guidoglorioso01/Proyecto-DigitalesII-APOLO1/README.md

# Proyecto-DigitalesII-APOLO1
Proyecto de tecnicas digitales 2. "Apolo 1" Equipo de sonido para procesar señales de audio en tiempo real

En este repositorio existen dos proyectos:
* Proyecto_Digitales/a2dp_sink: en esta carpeta se encuentra el codigo del ESP32.
* TDII-Proyecto_Apolo-Grupo1: en esta carpeta se encuentra el codigo del nucleoF401Re

  En la carpeta "Documentacion" se encontraran todos los documentos relacionados con el proyecto y su funcionamiento.
