guidoglorioso01/Proyecto-DigitalesII-APOLO1/Documentos/Control Automático de ganancia con corrección en tiempo real V2.pdf

Control automatico de ganancia con correcci ´ | on en ´

# tiempo real

Universidad Tecnologica Nacional-FRBA ´

1

st Nicolas Tobias Alamaraz
Universidad Tecnologica Nacional-FRBA ´ CABA, Buenos Aires, Argentina nalmaraz@frba.utn.edu.ar

2

nd Guido Ignacio Glorioso Rego
Universidad Tecnologica Nacional-FRBA ´ CABA, Buenos Aires, Argentina guido.glorioso@frba.utn.edu.ar

3

rd Axel Nathanel Nahum
Universidad Tecnologica Nacional-FRBA ´ CABA, Buenos Aires, Argentina anahum@frba.utn.edu.ar

4

th Santiago Eduardo Palozzo
Universidad Tecnologica Nacional-FRBA ´ CABA, Buenos Aires, Argentina spalozzo@frba.utn.edu.ar

Abstract—Con el avance de la tecnología, los sistemas de
audio en general han dejado de ser solo exclusivos para ´ | ambitos ´
comerciales o industriales (por ejemplo cines o teatros). Podemos encontrarlos, por ejemplo, en equipos sound round, parlantes plug and play o televisores. Es por esto que el desarrollo de herramientas para controlar el audio cobra especial sentido.
En este caso se desarrollo y caracteriz ´ | o un sistema de control ´
de loudness. Es decir, un dispositivo que regule la ganancia del sistema de tal modo que independientemente de la entrada, siempre a la salida se obtiene el mismo nivel de sonoridad. Para medir loudness se utilizo la norma ITU-R BS.1770. Por ´ otro lado, para caracterizar al sistema se determino el nivel de ´
distorsion arm ´ | onica (THD) que aporta. A tal fin se probaron ´
diferentes configuraciones de loudness para la entrada. El THD fue medido tanto en la salida digital (I2S) como en la salida analogica (sobre el parlante). Se obtuvo que el caso de mayor ´
distorsion es de 1.52% en la salida anal ´ | ogica para un set point ´
de 60 LKFS y una frecuencia de 500Hz.

Index Terms—Loudness, Sistema de control, THD, AGC

I. INTRODUCCION´

A la hora de reproducir una pista de audio muchas veces ocurre que dependiendo del dispositivo que grabo el sonido, o ´ bien debido al post-procesamiento que se le aplique, existe un gran contraste entre los niveles de potencia de un stream y el otro. Por ejemplo, si reproducimos una cancion grabada en un ´ estudio y luego reproducimos un recital grabado en vivo de forma casera probablemente el nivel de sonido que perciba el oído humano sea diferente para ambas pistas de audio. Por lo
tanto, esta situacion genera una constante correcci ´ | on manual ´
por parte del usuario en el nivel de volumen del reproductor para ajustar la potencia de audio cada vez que cambie de pista. Entonces, surge la necesidad de realizar esta correccion de ´ manera automatica, buscando una mayor comodidad y mejor ´ experiencia de usuario.

La variable física que mide la potencia de audio que percibe el humano se denomina sonoridad (en ingles´ loudness) y se mide en LKFS (Loudness, K-weighted, relative to Full Scale).
Esta variable esta definida por la norma ´ | | ITU-R BS.1770 [1]
junto con su algoritmo de medicion. ´

Hoy en día es comun encontrar sistemas de control de ´ Loudness en aplicaciones mas bien industriales. Por ejem- ´ plo, en emisoras de radio, estudios de grabacion, equipos ´ de transmision de audio en vivo o en distintos software de ´
remasterizacion. Es decir est ´ | an abocados a un uso m ´ | as bien ´
profesional e industrial. Aquí priman marcas como Orban [2], SSL [3], DBX [4]. Sin embargo se pueden llegar a encontrar en algunos sistemas de audio hobbistas, por ejemplo, en procesadores de audio domesticos o distintas aplicaciones de ´ audio. Algunos ejemplos pueden ser procesadores Behringer
[5] y Yamaha [6] para sistemas home theater. En base a que no hay tanta oferta de estos sistemas en equipos plug and play de bajo costo para usuarios aficionados (no profesionales) es que se decidio desarrollar un sistema de control de loudness ´ para un procesador de audio de propia autoría.
A. ¿Que es el loudness?
Segun la ´ | norma antes mencionada, el nivel de loudness de
una senal se refiere a la percepci ˜ | on subjetiva de la intensidad ´
o volumen de un sonido por parte de un oyente. En otras palabras, es la medida de cuan fuerte o suave se escucha una ´
senal de audio en funci ˜ | on de c ´ | omo la percibe el o ´ | ído humano.
El loudness no se mide directamente en decibelios (dB), como lo haría el nivel de presion sonora, sino que tiene en cuenta la ´ sensibilidad del oído humano a diferentes frecuencias y ajusta la medicion en consecuencia. ´

B. ¿Como se mide el loudness? ´

Como ya mencionamos al comienzo de esta seccion, la ´ norma ITU-R BS.1770 propone un algoritmo para la medicion´ de loudness de un stream de audio (medido en LKFS).
De esta manera, el objetivo es cuantificar el nivel de
loudness de una senal de manera representativa para el o ˜ | ído
humano y en base a ello ajustar el nivel de sonoridad. Este ajuste no debe ser destructivo para la senal, buscando tener ˜ la menor distorsion posible. Sin embargo, hay que tener en ´ cuenta que dicha correccion implica una ganancia variable en ´ el tiempo, dando lugar a posibles distorsiones en la senal. ˜

II. METODOLOGÍA GENERAL

El sistema de control tiene un diagrama en bloques como el siguiente (fig. 1):

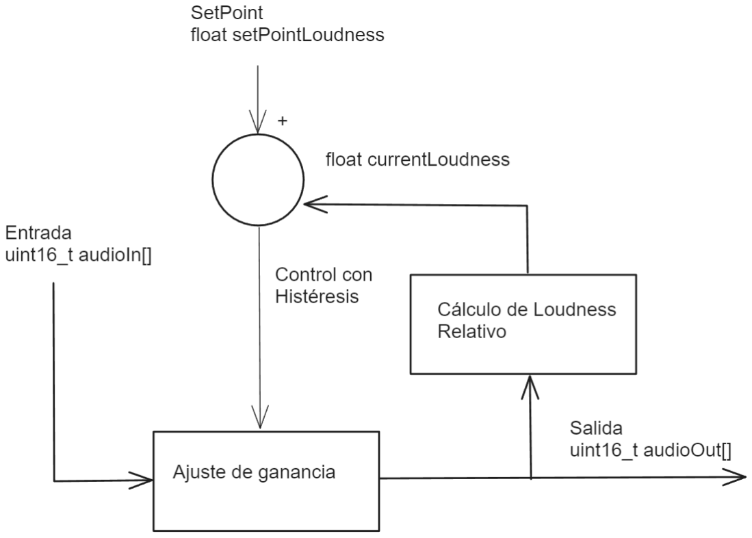
[picture p3: figure]

Fig. 1. Diagrama en bloques

Las etapas son:

- Entrada: senal de audio de entrada ˜
- Ajuste de ganancia: correccion en base al loudness con ´ un nivel de histeresis ´
- Set Point: valor de referencia de Loudness configurado por el usuario
- Calculo de loudness relativo: Este es el algoritmo que plantea la norma para la medicion de Loudness ´
- Salida de audio: senal de audio con la correcci ˜ | on´
pertinente

En este sistema se recibe un stream de audio vía Bluetooth
[7] y se le aplica el algoritmo de medicion de loudness. Luego, ´ en funcion del valor obtenido se le aplica una ganancia que ´
amplifique o atenue la se ´ | nal para que el nivel de loudness se ˜
mantenga en el valor configurado por el usuario.
A. Algoritmo de medicion de Loudness ´

Para medir el nivel de sonoridad la norma ITU indica los siguientes pasos:

Primero, aplicarle los filtros que adapten la senal pon- ˜
derando en funcion del comportamiento del o ´ | ído humano
(filtros digitales con coeficientes definidos por la norma a 48kHz). Este filtro es aplicado a cada canal.
Segundo, se calcula la potencia de la senal dividida en blo- ˜ ques de tiempo con un solapamiento determinado (recomienda bloque de 0.4 segundos y 75% de solapamiento). En otras
palabras se toman los ultimos 0.4 segundos de informaci ´ | on y ´
se calcula la potencia. Luego, se avanzan 0.1 segundos y se vuelve a calcular la potencia de los siguientes 0.4 segundos. Se repetira el proceso con la totalidad del stream de audio. ´ Tercero, se le aplica la siguiente expresion a cada bloque ´ de potencia calculado.

LKG = −0.691 + 10 log10X

i

Gi

1
|Jg|

X

Jg

Zij

- − 10LKF S

(1)

Donde:

- i: Representa los distintos canales. Por ejemplo canal izquierdo, derecho, sub-woofer, etc
- Gi
: coeficientes de ponderacion de cada canal ´
- Zij : Energía de la senal en un tiempo de gate para el ˜ canal i en el bloque de tiempo j
- Jg: Son los elementos que superan el umbral de disparo de 70 LKFS
- |Jg|: Cantidad de elementos que superan el umbral de disparo
B. Adaptacion del algoritmo para utilizarse dentro de un ´ microcontrolador en tiempo real

Para adaptar el algoritmo al microcontrolador es necesario resolver dos problematicas principalmente. La primera es que ´ no es un algoritmo nativo para aplicarse en tiempo real y la segunda es que el hecho de tener que almacenar grandes tiem-pos de audio es sumamente inviable para un microcontrolador que esta muy limitado en memoria. ´

Para resolver la primera problematica se adopt ´ | o por imple- ´
mentar un buffer circular que almacene los ultimos 3 segundos ´ de audio. Estos son los que representan el período total del calculo. Es decir, se aplicaron las ventanas de 0.4 segundos ´ sobre este buffer de 3 segundos.

Por otro lado, al tener que resolver una integral de períodos de 0.4 segundos de manera reiterativa se opto por definir ´ sub-ventanas de 0.1 segundos. De esta manera se redujo el costo computacional, dado que el unico procesamiento que ´ debería hacer el sistema es calcular la energía de los ultimos ´ 0.1 segundos y aprovechar todo el procesamiento previo para así ir formando los bloques de 0.4 segundos. Puede verse graficamente este proceso con la siguiente imagen (fig. 2) ´

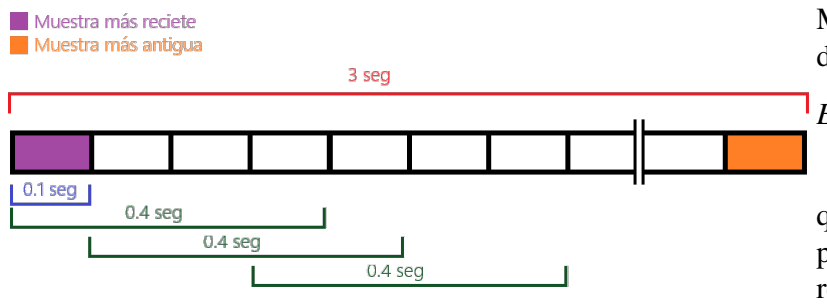
[picture p4: figure]

Fig. 2. Enter Caption

C. Ajuste de ganancia

Luego de analizar el desempeno de distintos algoritmos de ˜
correccion, se opt ´ | o por un agregar un nivel de hist ´ | eresis H ´
al sistema de forma que una vez conseguido un equilibrio no
varíe la ganancia por aumentos pequenos de se ˜ | nal. El valor ˜
de H quedo definido en 5 LFKS de manera emp ´ | | írica ya que
conseguía los mejores resultados.
D. Diagranma en bloques del Hardware

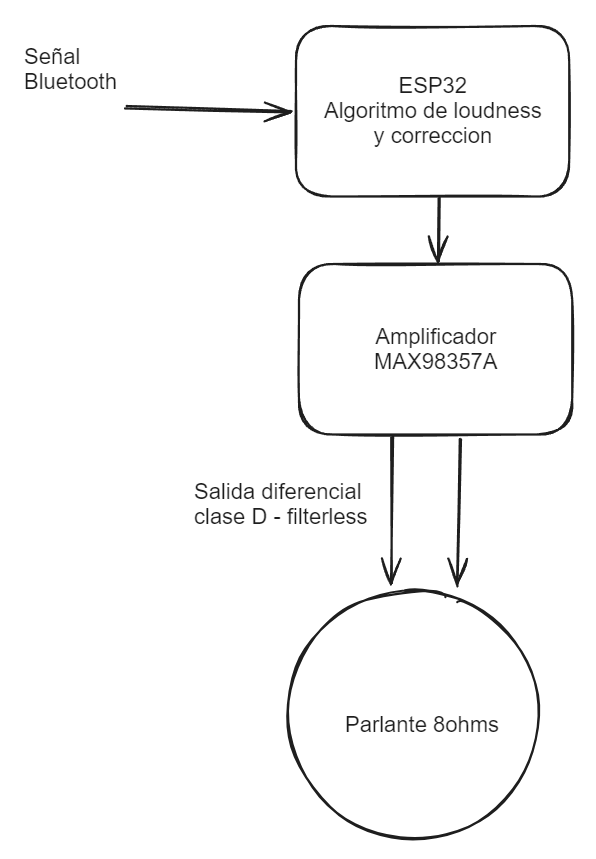
[picture p5: figure]

Fig. 3. Hardware

(fig. 3)
En cuanto a Hardware se tiene un microcontrolador ESP32
[8] utilizado para desarrollar el sistema de control. Mediante
este, se gestiona la recepcion de la se ´ | nal de audio v ˜ | ía Bluetooth
y aplica el proceso de medicion de loudness para as ´ | | í definir
un valor de ganancia.

En cuanto a la salida, el microcontrolador entrega una
senal I2S [9] que es recibida por un m ˜ | odulo amplificador ´

MAX98357A [10]. Estese encarga de recibir la senal I2S, ˜ decodificarla y amplificarla con un amplificador clase D.

E. Interfaz de usuario
Para controlar el SetPoint se disenõ una aplicaci ´ | on de PC ´
que se conecta con el microcontrolador vía UART [11] y permite ademas graficar los valores de loudness en tiempo ´
real, ademas de ir guard ´ | andolos en un archivo ´ | CSV (Comma-
Seperated Values).

Seleccion de puerto y loudness: ´

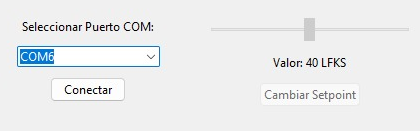
[picture p6: figure]

Fig. 4. Seleccion de puerto y loudness del sistema ´

En primer lugar se observa la seleccion del ´ | puerto y el
loudness (fig. 4). Esta misma funciona de la siguiente manera:
Seleccion de puerto: ´ | Se debe seleccionar el puerto, una
vez conectado el sistema a la PC. Al pulsar el boton conectar, ´ ya se podra actuar sobre el sistema. ´

Cambiar SetPoint: Se elije el valor de loudness que se requiera para el sistema. Este se enviara al microcontrolador ´
mediante la comunicacion serie ´ | UART.

Iniciar/parar ploteo: comienza o termina el registro de datos ploteando los ultimos 30 segundos y guardando el ´ registro completo en un archivo CSV (fig. 5).

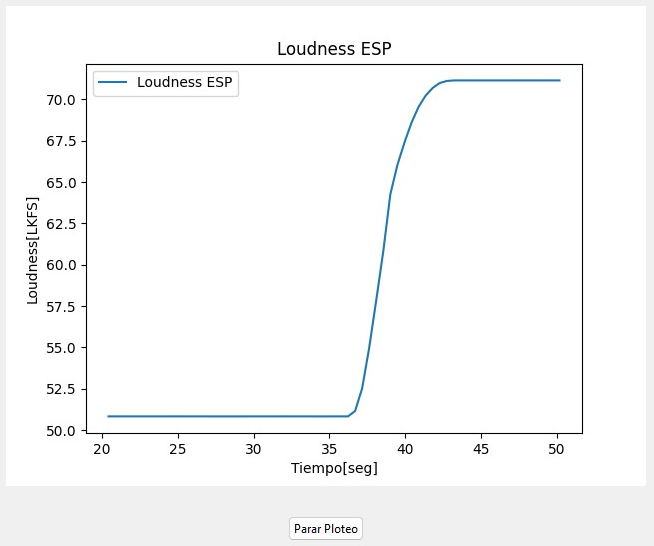
[picture p7: figure]

Fig. 5. Grafico de Loudness en funcion del tiempo

III. PROCESAMIENTO DE LOS DATOS

A. Magnitud a medir

Dado que hay una ganancia variable en funcion del tiempo, ´ es de interes conocer el THD (Total harmonic distortion) [12] ´
del sistema. Por lo tanto, se realizo la medici ´ | on de THD para ´
diferentes valores de loudness teniendo como senal de entrada ˜ un tono senoidal puro a distintas frecuencias.
B. Esquema de medicion´

El primer punto de medicion del sistema se encuentra a la ´ salida del microcontrolador. Esta senal es del tipo I2S, por lo ˜ tanto se mide con un analizador logico. El segundo punto de ´ medicion es a la salida del amplificador. El mismo cuenta con ´ una salida tipo bridge o diferencial, con lo cual es necesario medir la senal de ambos bornes de entrada del parlante. Para ˜
las mediciones realizadas se adopto el esquema de conexi ´ | on´
de la figura 6.
C. Tonos de prueba

Para caracterizar el sistema, se utilizo una senal de entrada ˜ senoidal a distintas frecuencias (500, 1000 y 10.000 Hz) y distintos valores de loudness (50, 60 y 70 LFKS). Se eligieron estos valores debido a que cubren gran parte del espectro audible [13] (que para un oído joven y sano va de 20Hz a 20kHz) y por otro lado, con los valores de referencias adoptados se cubren los niveles de Loudness mas frecuentes ´ para un usuario promedio.

D. Adaptacion de salida del modulo amplificador ´

Un aspecto a tener en cuenta sobre las mediciones es que los amplificadores MAX98357 son del tipo clase D y debido a su principio de funcionamiento en la salida se presenta una portadora de 300KHz combinada con la senal de audio. Esto ˜ implica que para recuperar la informacion hay que filtrar la ´ portadora. Una vez llegado a este punto que se tiene el stream de audio limpio se le aplica el algoritmo de THD para evaluar la distorsion. ´

Para visualizar el comportamiento del amplificador clase D, se calculo la ´ FFT [14] (Fast Fourier Transform) a la senal de ˜ salida del sistema antes y despues del filtrado para observar ´ las componentes frecuenciales que esta presenta.

E. Instrumentos y hardware utilizado

Para las mediciones se utilizaron los siguientes equipos de medicion: ´

- Analizador logico Duaitek LA2408 [15] ´
- Osciloscopio Agilent MSO-X 3024A [16]

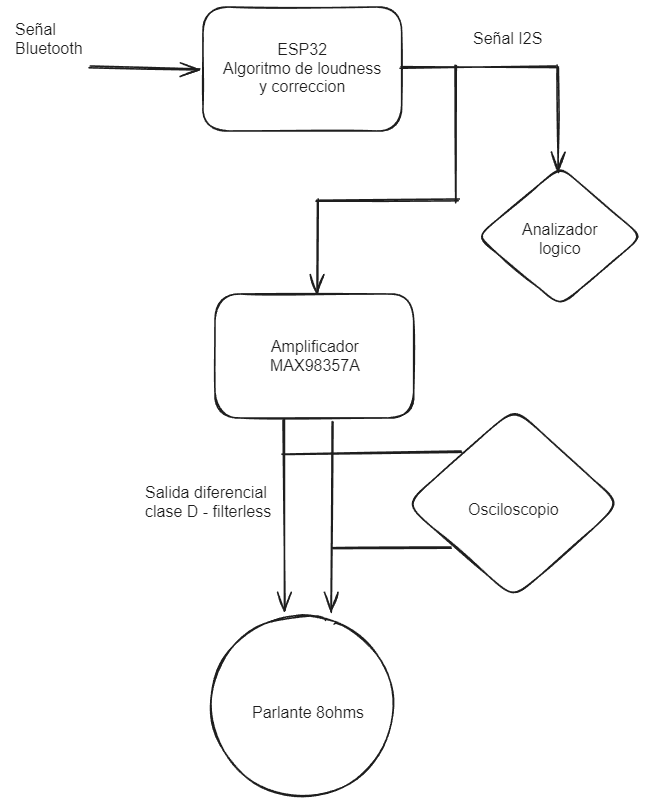
[picture p8: figure]

Fig. 6. Esquema de conexion del banco de medici ´ | on´

IV. RESULTADOS

Se adjuntan los diferentes graficos intermedios antes de ´
obtener el THD de las senales para la se ˜ | nal de prueba ˜
de 500Hz con un setpoint de 60LKFS tanto para la senal ˜ analogica como para la digital. Cabe destacar que este proceso ´ debe repetirse para cada una de las mediciones, es decir, todas las frecuencias con todos los set points. Para visualizar
todos los graficos de cada medici ´ | on puede consultarse en ´ | [2]
(Apendice) ´ | .
A. Senal anal ˜ | ogica a 500Hz con 60 LKFS ´

En la fig. 7 se observa la senal de ambos canales referidas a ˜ tierra. Este oscilograma es para mostrar que ambas senales por ˜
separado no permiten la reconstruccion de la se ´ | nal original. ˜

En la fig. 8 se muestra la diferencia entre la senal de ambos ˜ canales del osciloscopio. Puede verse que se tiene la portadora de una muy alta frecuencia y la senal que modula a dicha ˜ portadora.

Por otro lado, en la fig. 9 puede verse la FFT de la senal ˜ diferencial anterior. Se observa que en las bajas frecuencias
esta la senoidal de inter ´ | es y en 150kHz est ´ | a la se ´ | nal portadora. ˜
Haciendo pruebas puede verse que esta portadora es una senal ˜
cuadrada y dependiendo de cual es la se ´ | nal de informaci ˜ | on´

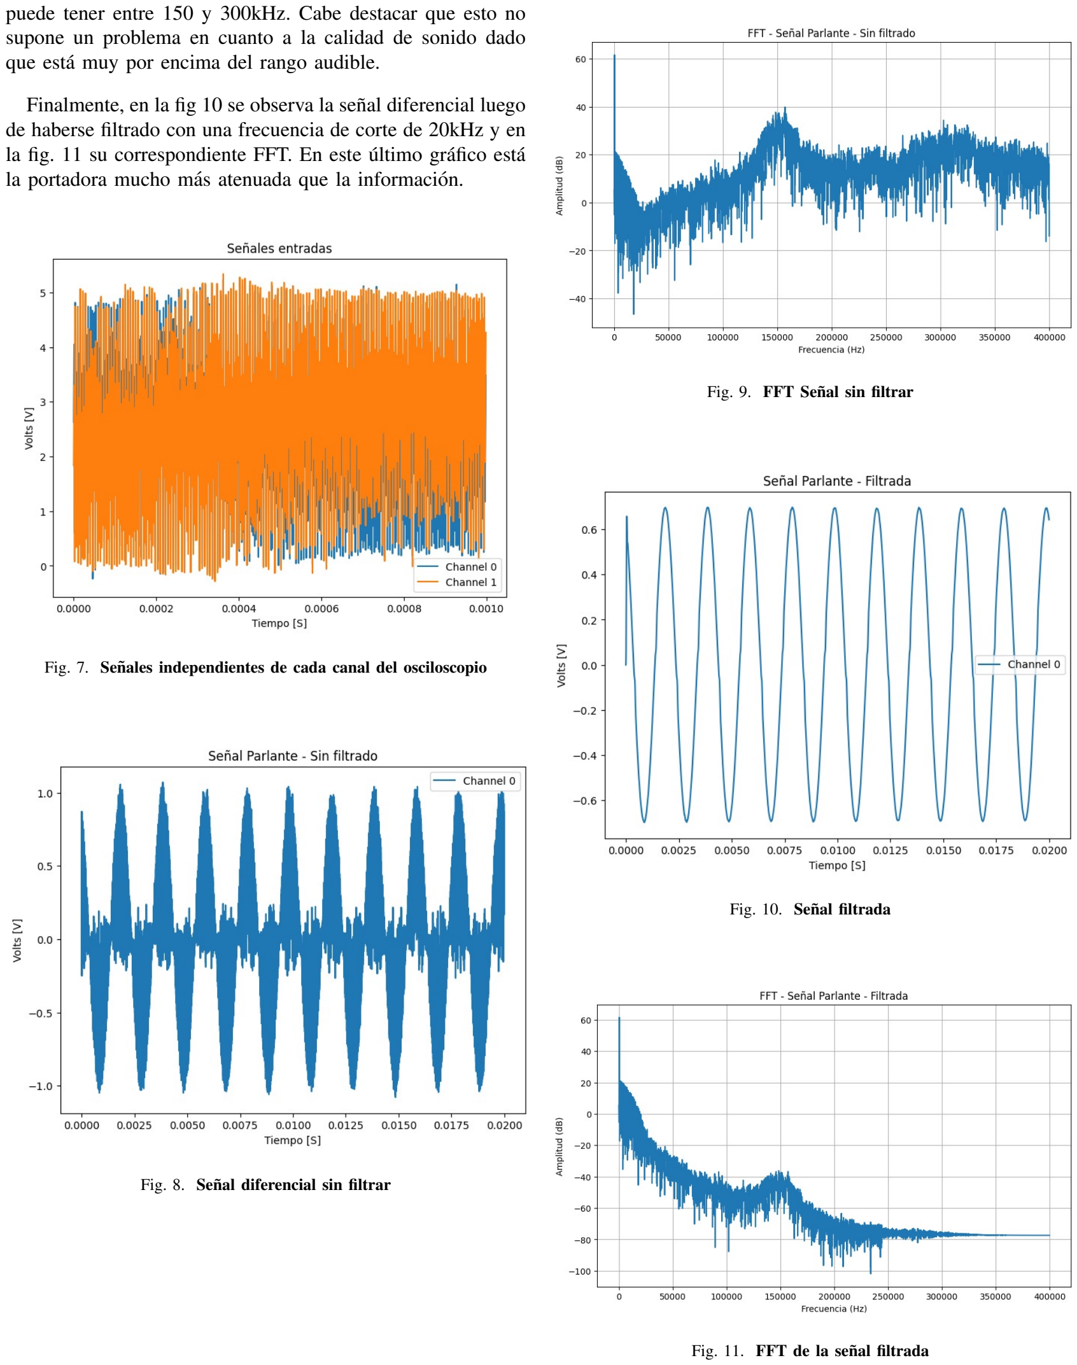
[picture p9: page 5]

puede tener entre 150 y 300kHz. Cabe destacar que esto no supone un problema en cuanto a la calidad de sonido dado que esta muy por encima del rango audible. ´

Finalmente, en la fig 10 se observa la senal diferencial luego ˜ de haberse filtrado con una frecuencia de corte de 20kHz y en
la fig. 11 su correspondiente FFT. En este ultimo gr ´ | afico est ´ | á
la portadora mucho mas atenuada que la informaci ´ | on. ´

Fig. 7. Senales independientes de cada canal del osciloscopio ˜

Fig. 8. Senal diferencial sin filtrar ˜

Fig. 9. FFT Senal sin filtrar ˜

Fig. 10. Senal filtrada ˜

Fig. 11. FFT de la senal filtrada ˜

B. Senal digital a 500Hz 60 LKFS ˜

En la fig. 12 se observa la senal temporal medida con el ˜ analizador logico a la salida del microcontrolador y en la fig. ´ 13 se observa su correspondiente FFT.

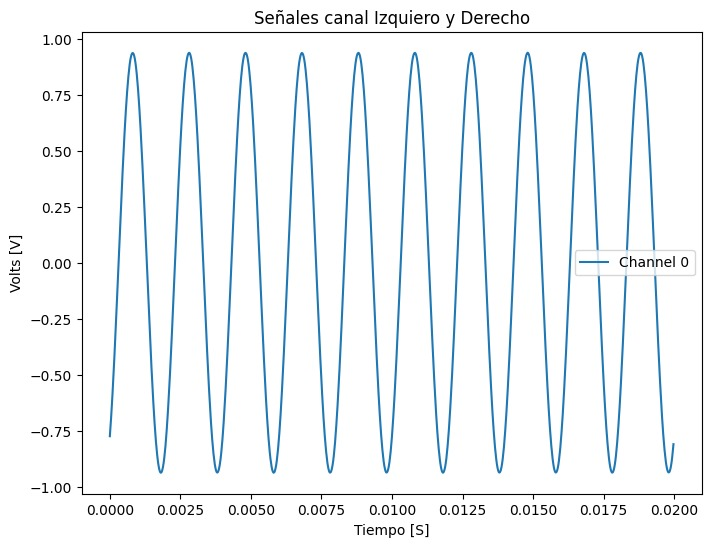
[picture p10: figure]

Fig. 12. Senal I2S ˜

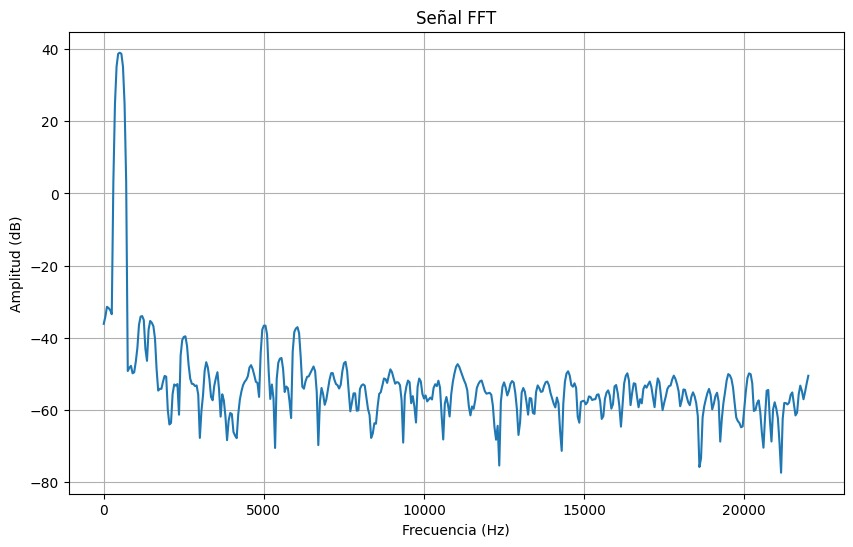
[picture p11: figure]

Fig. 13. FFT de la senal I2S ˜

C. Tabla con los resultados obtenidos de THD

Analizando cada una de las senales senoidales con cada ˜ uno de los set-points se obtubieron los resultados de la tabla
1 (resultados senal I2S) y tabla 2 (resultados se ˜ | nal anal ˜ | ogica). ´
Parametro ´ | 70 LKFS | 60 LKFS | 50 LKFS
THD % - ESP32 (500Hz) | 0,548% | 0,235% | 0,527%
THD % - ESP32 (1KHz) | 0,453% | 0,354% | 0,202%
THD % - ESP32 (10KHz) | 0,059% | 0,124% | 0,229%

TABLE I

Parametro ´ | 70 LKFS | 60 LKFS | 50 LKFS
THD % - Parlante (500Hz) | 1,25% | 1,52% | 1,03%
THD % - Parlante (1KHz) | 0,56% | 0,97% | 0,9%
THD % - Parlante (10KHz) | 0,33% | 0,33% | 0,33%

TABLE II

V. ANALISIS DE LOS RESULTADOS Y CONCLUSIONES ´

En base a las tablas de resultados (tabla 1 y tabla 2), se
observa que la tasa de distorsion aumenta para se ´ | nales de ˜
menor frecuencia y ademas aumenta cuando estamos en un ´ rango de LKFS cercano a 60.

Por otro lado, puede verse que el mayor aporte de distorsion´ lo hace el modulo amplificador. Esto podemos verlo en la ´
comparacion de los THD de la se ´ | nal digital y la anal ˜ | ogica ´
respectivamente.
Por ultimo, el peor caso de distorsi ´ | on se dio con una se ´ | nal ˜
de entrada de 500Hz con un nivel de loudness de 60 LKFS obteniendo un THD de 1.52%.
| VI. DESARROLLO A FUTURO

Una de las mejoras a futuro resulta ser la medicion del ´ THD en el transitorio, es decir, mientras que la senal se ˜ este estabilizando entre dos puntos de trabajo (porque cambio el setpoint). Esto se debe realizar mediante la salida digital debido a que el transitorio dura aproximadamente unos 10 segundos. Esto supone un problema para medirse con el osciloscopio debido la profundidad de memoria (no se podrá realizar mediante la salida analogica). ´

Por otro lado, se podría realizar un grafico de THD en ´ funcion del setpoint de loudness elegido y parametrizando ´ diferentes frecuencias. Para conseguir esto de una manera mas precisa se deben realizar las mediciones para una mayor cantidad de setpoints y frecuencias de trabajo.

APENDICE ´

[1] NBviewer de Loudness (https://nbviewer.org/github/guidoglorioso01/Jupyter-Notes/blob/main/Controlador%20de%20Loudness/Control%20de%20loudness.ipynb)
[2] NBviewer de resultados (https://nbviewer.org/github/guidoglorioso01/Proyecto-Medida_1-G1/blob/main/Notebooks/Mediciones%20y%20resultados/notebook%20Proyecto.ipynb)
[3] NBviewer de datos (https://nbviewer.org/github/guidoglorioso01/Proyecto-Medida_1-G1/tree/main/Notebooks/)

REFERENCES

[1] Norma ITU-R BS.1770 (https://extranet.itu.int/brdocsearch/R-REC/R-REC-BS/R-REC-BS.1770/R-REC-BS.1770-4-201510-I/R-REC-BS.1770-4-201510-I!!PDF-S.pdf)
[2] Orban (https://www.orban.com/)
[3] SSL (https://www.solidstatelogic.com/)
[4] DBX (https://dbxpro.com/en)
[5] Procesadores Behringer (https://www.behringer.com/behringer/search-results.html?brandName=behringer&queryStr=processor)

[6] Procesadores Yamaha (https://es.yamaha.com/es/search/index.html?search=procesadores)
[7] Bluetooth-A2DP-API-Application-Example (https://docs.espressif.com/projects/esp-idf/en/latest/esp32/api-reference/bluetooth/esp_a2dp.html)
[8] ESP32 (https://www.espressif.com/en/products/socs/esp32)
[9] Inter-IC Sound (I2S) (https://docs.espressif.com/projects/esp-idf/en/stable/esp32/api-reference/peripherals/i2s.html)
[10] Datasheet del amplificador MAX98357 (https://www.analog.com/media/en/technical-documentation/data-sheets/max98357a-max98357b.pdf)
[11] Universal Asynchronous Receiver/Transmitter (UART) (https://docs.espressif.com/projects/esp-idf/en/latest/esp32/api-reference/peripherals/uart.html)
[12] Distorsion arm ´ onica total (THD) ´ (https://es.wikipedia.org/wiki/Distorsi%C3%B3n_arm%C3%B3nica)
[13] Espectro audible (https://es.wikipedia.org/wiki/Espectro_audible)
[14] FFT (https://es.wikipedia.org/wiki/Transformada_r%C3%A1pida_de_Fourier)
[15] Analizador logico Duaitek LA2408 ´ (https://www.uctronics.com/download/Amazon/U6041_Saleae.pdf)
[16] Osciloscopio Agilent MSO-X 3024A (https://www.testequipmenthq.com/datasheets/Agilent-MSOX3024A-Datasheet.pdf)
