guidoglorioso01/Proyecto-DigitalesII-APOLO1/Proyecto_Digitales/a2dp_sink/components/esp-dsp-master/docs/esp_bm_results.csv

# This contents of this file is produced by running "DSP Benchmarks data" tests as explained in ESP-IDF Programming Guide and
# README.me for ESP-DSP.
# When updating this file | remember to run build_bm_table.py script to rebuild the table in documentation.
Esp32s3
**Dot Product**
dsps_dotprod_f32 for N=256 points | 449 | 1330 | 1 | 3
dsps_dotprode_f32 for N=256 points with step 1 | 1326 | 2603 | 1 | 3
dsps_dotprod_s16 for N=256 points | 323 | 3397 | 1 | 3
**FIR Filters**
dsps_fir_f32 1024 input samples and 256 coefficients | 443690 | 1350673 | 1 | 3
dsps_fird_f32 1024 samples 256 coeffs and decimation 4 | 115494 | 349202 | 1 | 3
**FFTs Radix-2 32 bit Floating Point**
dsps_fft2r_fc32 for 64 complex points | 5142 | 6850 | 1 | 3
dsps_fft2r_fc32 for 128 complex points | 11706 | 15638 | 1 | 3
dsps_fft2r_fc32 for 256 complex points | 26303 | 34939 | 1 | 3
dsps_fft2r_fc32 for 512 complex points | 58435 | 77175 | 1 | 3
dsps_fft2r_fc32 for 1024 complex points | 128697 | 169738 | 1 | 3
**FFTs Radix-4 32 bit Floating Point**
dsps_fft4r_fc32 for 64 complex points | 3345 | 5119 | 1 | 3
dsps_fft4r_fc32 for 256 complex points | 15522 | 25223 | 1 | 3
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
