guidoglorioso01/Proyecto-DigitalesII-APOLO1/TDII-Proyecto_Apolo-Grupo1/Core/Src/main.c

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
/* Includes ------------------------------------------------------------------*/
#include "main.h"
#include "cmsis_os.h"
#include "app_touchgfx.h"

/* USER CODE BEGIN PTD */
#include "Driver_I2S.h"
#include "process.h"
/* USER CODE END PTD */

ADC_HandleTypeDef hadc1;

CRC_HandleTypeDef hcrc;

I2C_HandleTypeDef hi2c1;

I2S_HandleTypeDef hi2s2;
I2S_HandleTypeDef hi2s3;
DMA_HandleTypeDef hdma_spi2_rx;
DMA_HandleTypeDef hdma_spi3_tx;

SPI_HandleTypeDef hspi1;
DMA_HandleTypeDef hdma_spi1_tx;

TIM_HandleTypeDef htim1;
TIM_HandleTypeDef htim2;

UART_HandleTypeDef huart2;

osThreadId defaultTaskHandle;
/* USER CODE BEGIN PV */
SemaphoreHandle_t semSaveData;
SemaphoreHandle_t semProcessData; // semaforo para indicar si se puede tocar o no el buffer de entrada/salida
SemaphoreHandle_t semCalcCoefs;
SemaphoreHandle_t semI2CResource;
SemaphoreHandle_t semCalcVolume;
SemaphoreHandle_t semDataReady;

/* USER CODE END PV */

void SystemClock_Config(void);
void PeriphCommonClock_Config(void);
static void MX_GPIO_Init(void);
static void MX_DMA_Init(void);
static void MX_USART2_UART_Init(void);
static void MX_ADC1_Init(void);
static void MX_CRC_Init(void);
static void MX_TIM2_Init(void);
static void MX_I2C1_Init(void);
static void MX_I2S3_Init(void);
static void MX_TIM1_Init(void);
static void MX_I2S2_Init(void);
static void MX_SPI1_Init(void);
void StartDefaultTask(void const * argument);

/* USER CODE BEGIN 0 */

/*
uint32_t tim1_cuenta=0;
extern TIM_HandleTypeDef htim2;
extern uint32_t tim1_cuenta;
tim1_cuenta = 0 ;
__HAL_TIM_SET_COUNTER(&htim2,0);
tim1_cuenta = __HAL_TIM_GET_COUNTER(&htim2);
*/

//I2S 2
void HAL_I2S_RxCpltCallback(I2S_HandleTypeDef *hi2s) {
	callbackI2SRx_CMP();
}
void HAL_I2S_RxHalfCpltCallback(I2S_HandleTypeDef *hi2s) {
	callbackI2SRx_HALF();
}

//I2S 3
void HAL_I2S_TxCpltCallback(I2S_HandleTypeDef *hi2s) {
	callbackI2STx_CMP();
}
void HAL_I2S_TxHalfCpltCallback(I2S_HandleTypeDef *hi2s) {
	callbackI2STx_HALF();
}
void HAL_SPI_TxCpltCallback(SPI_HandleTypeDef *hspi) {
	callbackSPITx_CMP();
}
void HAL_SPI_TxHalfCallback(SPI_HandleTypeDef *hspi) {
	callbackSPITx_HALF();
}

void HAL_TIM_TriggerCallback(TIM_HandleTypeDef *htim){

}
/* USER CODE END 0 */

/**
  * @brief  The application entry point.
  * @retval int
  */
int main(void)
{
  /* MCU Configuration--------------------------------------------------------*/

  /* Reset of all peripherals, Initializes the Flash interface and the Systick. */
  HAL_Init();

  /* Configure the system clock */
  SystemClock_Config();

/* Configure the peripherals common clocks */
  PeriphCommonClock_Config();

  /* Initialize all configured peripherals */
  MX_GPIO_Init();
  MX_DMA_Init();
  MX_USART2_UART_Init();
  MX_ADC1_Init();
  MX_CRC_Init();
  MX_TIM2_Init();
  MX_I2C1_Init();
  MX_I2S3_Init();
  MX_TIM1_Init();
  MX_I2S2_Init();
  MX_SPI1_Init();
  MX_TouchGFX_Init();
  /* Call PreOsInit function */
  MX_TouchGFX_PreOSInit();
  /* USER CODE BEGIN 2 */
  HAL_TIM_Base_Start(&htim2); // lo uso para medir tiempos

  /* USER CODE END 2 */

  /* USER CODE BEGIN RTOS_MUTEX */
  /* add mutexes, ... */
  /* USER CODE END RTOS_MUTEX */

  /* USER CODE BEGIN RTOS_SEMAPHORES */
  /* add semaphores, ... */
  init_semaphores();

  /* USER CODE END RTOS_SEMAPHORES */

  /* USER CODE BEGIN RTOS_TIMERS */
  /* start timers, add new ones, ... */
  /* USER CODE END RTOS_TIMERS */

  /* USER CODE BEGIN RTOS_QUEUES */
  /* add queues, ... */
#if 0
  /* USER CODE END RTOS_QUEUES */

  /* Create the thread(s) */
  /* definition and creation of defaultTask */
  osThreadDef(defaultTask, StartDefaultTask, osPriorityNormal, 0, 128);
  defaultTaskHandle = osThreadCreate(osThread(defaultTask), NULL);

  /* USER CODE BEGIN RTOS_THREADS */
#endif

  init_tasks();

  /* add threads, ... */
  vTaskStartScheduler();
  /* USER CODE END RTOS_THREADS */

  /* Start scheduler */
  osKernelStart();

  /* We should never get here as control is now taken by the scheduler */
  /* Infinite loop */
  /* USER CODE BEGIN WHILE */
  while (1)
  {
    /* USER CODE END WHILE */

    /* USER CODE BEGIN 3 */
  }
  /* USER CODE END 3 */
}

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
/* USER CODE BEGIN Header_StartDefaultTask */
/**
  * @brief  Function implementing the defaultTask thread.
  * @param  argument: Not used
  * @retval None
  */
/* USER CODE END Header_StartDefaultTask */
void StartDefaultTask(void const * argument)
{
  /* USER CODE BEGIN 5 */
  /* Infinite loop */
  for(;;)
  {
    osDelay(1);
  }
  /* USER CODE END 5 */
}

/**
  * @brief  Period elapsed callback in non blocking mode
  * @note   This function is called  when TIM3 interrupt took place, inside
  * HAL_TIM_IRQHandler(). It makes a direct call to HAL_IncTick() to increment
  * a global variable "uwTick" used as application time base.
  * @param  htim : TIM handle
  * @retval None
  */
void HAL_TIM_PeriodElapsedCallback(TIM_HandleTypeDef *htim)
{
  if (htim->Instance == TIM3) {
    HAL_IncTick();
  }
}

/**
  * @brief  This function is executed in case of error occurrence.
  * @retval None
  */
void Error_Handler(void)
{
  /* USER CODE BEGIN Error_Handler_Debug */
  /* User can add his own implementation to report the HAL error return state */
  __disable_irq();
  while (1)
  {
  }
  /* USER CODE END Error_Handler_Debug */
}

#ifdef  USE_FULL_ASSERT
/**
  * @brief  Reports the name of the source file and the source line number
  *         where the assert_param error has occurred.
  * @param  file: pointer to the source file name
  * @param  line: assert_param error line source number
  * @retval None
  */
void assert_failed(uint8_t *file, uint32_t line)
{
  /* USER CODE BEGIN 6 */
  /* User can add his own implementation to report the file name and line number,
     ex: printf("Wrong parameters value: file %s on line %d\r\n", file, line) */
  /* USER CODE END 6 */
}
#endif /* USE_FULL_ASSERT */
