guidoglorioso01/Proyecto-DigitalesII-APOLO1/TDII-Proyecto_Apolo-Grupo1/TDII-Proyecto_Apolo-Grupo1.ioc

Mcu.UserName=STM32F401RETx
PA0-WKUP.Signal=ADCx_IN0
PA11.GPIO_Label=WS_CD
PA11.Signal=S_TIM1_CH4
PA12.Signal=S_TIM1_ETR
PA13.GPIO_Label=TMS
PA13.Signal=SYS_JTMS-SWDIO
PA14.GPIO_Label=TCK
PA14.Signal=SYS_JTCK-SWCLK
PA15.Signal=I2S3_WS
PA2.GPIO_Label=USART_TX
PA2.Signal=USART2_TX
PA3.GPIO_Label=USART_RX
PA3.Signal=USART2_RX
PA5.Signal=SPI1_SCK
PA7.Signal=SPI1_MOSI
PB12.GPIO_Label=WS_PIN
PB12.Signal=I2S2_WS
PB13.Signal=I2S2_CK
PB8.Signal=I2C1_SCL
PB9.Signal=I2C1_SDA
PC10.Signal=I2S3_CK
PC12.Signal=I2S3_SD
PC13-ANTI_TAMP.GPIO_Label=B1 [Blue PushButton]
PC13-ANTI_TAMP.Signal=GPXTI13
PC14-OSC32_IN.Signal=RCC_OSC32_IN
PC15-OSC32_OUT.Signal=RCC_OSC32_OUT
PC3.Signal=I2S2_SD
