guidoglorioso01/Proyecto-DigitalesII-APOLO1/TDII-Proyecto_Apolo-Grupo1/Core/Inc/main.h

#define B1_Pin GPIO_PIN_13
#define B1_GPIO_Port GPIOC
#define USART_TX_Pin GPIO_PIN_2
#define USART_TX_GPIO_Port GPIOA
#define USART_RX_Pin GPIO_PIN_3
#define USART_RX_GPIO_Port GPIOA
#define WS_PIN_Pin GPIO_PIN_12
#define WS_PIN_GPIO_Port GPIOB
#define WS_CD_Pin GPIO_PIN_11
#define WS_CD_GPIO_Port GPIOA
#define TMS_Pin GPIO_PIN_13
#define TMS_GPIO_Port GPIOA
#define TCK_Pin GPIO_PIN_14
#define TCK_GPIO_Port GPIOA
