guidoglorioso01/Proyecto-DigitalesII-APOLO1/TDII-Proyecto_Apolo-Grupo1/Core/Src/Driver_I2C.c

/*
 * I2CDriver.c
 *
 *  Created on: 14 oct. 2023
 *      Author: guido
 */
#include <Driver_I2C.h>

UnionUserData local_data; // La uso para escribir en la estructura
uint8_t progress_music = 0;
uint8_t Buffer_tx[BUFFER_LEN];
uint8_t Buffer_rx[BUFFER_LEN];
extern SemaphoreHandle_t semI2CResource;

uint8_t save_config_esp(){
	uint8_t nbr_of_try = 0;
	xSemaphoreTake(semI2CResource,portMAX_DELAY);
	do{
		Buffer_tx[0] = LOAD_CONFIG_CMD;
		HAL_I2C_Master_Transmit(&hi2c1, SLAVE_ADDR, Buffer_tx , 1 ,HAL_MAX_DELAY); // Envio comando de guardar

		get_user_data(&local_data.datos);

		HAL_I2C_Master_Transmit(&hi2c1, SLAVE_ADDR, local_data.datosRaw , STRUCT_LENGHT ,HAL_MAX_DELAY); // Envio los datos del usuario

		vTaskDelay(300); // Cambiar por un vTaskDelay

		Buffer_tx[0] = STATE_COMAND_CMD;
		HAL_I2C_Master_Transmit(&hi2c1, SLAVE_ADDR, Buffer_tx , 1 ,HAL_MAX_DELAY); // Envio comando de verificar estado previo

		vTaskDelay(300);

		HAL_I2C_Master_Receive(&hi2c1,SLAVE_ADDR,Buffer_rx,1,HAL_MAX_DELAY);

		nbr_of_try++;
	}while((Buffer_rx[0] != COMAND_OK)&&(nbr_of_try<MAX_CMD_SEND));
	xSemaphoreGive(semI2CResource);
	if(nbr_of_try >= MAX_CMD_SEND)
		return ERROR;
	return SUCCESS;

}


uint8_t get_config_esp(){
	uint8_t nbr_of_try = 0;
	xSemaphoreTake(semI2CResource,portMAX_DELAY);
	do{
		Buffer_tx[0] = GET_CONFIG_CMD;
		HAL_I2C_Master_Transmit(&hi2c1, SLAVE_ADDR, Buffer_tx , 1 ,HAL_MAX_DELAY); // Envio comando de guardar

		vTaskDelay(300); // Cambiar por un vTaskDelay

		HAL_I2C_Master_Receive(&hi2c1,SLAVE_ADDR,local_data.datosRaw,STRUCT_LENGHT,HAL_MAX_DELAY);

		Buffer_tx[0] = STATE_COMAND_CMD;

		HAL_I2C_Master_Transmit(&hi2c1, SLAVE_ADDR, Buffer_tx , 1 ,HAL_MAX_DELAY); // Envio comando de verificar estado previo

		vTaskDelay(300);

		HAL_I2C_Master_Receive(&hi2c1,SLAVE_ADDR,Buffer_rx,1,HAL_MAX_DELAY);

		nbr_of_try++;
	}while((Buffer_rx[0] != COMAND_OK)&&(nbr_of_try<MAX_CMD_SEND));
	xSemaphoreGive(semI2CResource);
	if(nbr_of_try >= MAX_CMD_SEND)
		return ERROR;
	set_user_data(local_data.datos);

	return SUCCESS;
}


uint8_t send_cmd_esp(uint8_t CMD){
	uint8_t nbr_of_try = 0;
	xSemaphoreTake(semI2CResource,portMAX_DELAY);
	do{
		Buffer_tx[0] = CMD;
		HAL_I2C_Master_Transmit(&hi2c1, SLAVE_ADDR, Buffer_tx , 1 ,HAL_MAX_DELAY); // Envio comando de guardar

		Buffer_tx[0] = STATE_COMAND_CMD;
		HAL_I2C_Master_Transmit(&hi2c1, SLAVE_ADDR, Buffer_tx , 1 ,HAL_MAX_DELAY); // Envio comando de verificar estado previo

		vTaskDelay(300);

		HAL_I2C_Master_Receive(&hi2c1,SLAVE_ADDR,Buffer_rx,1,HAL_MAX_DELAY);

		nbr_of_try++;
	}while((Buffer_rx[0] != COMAND_OK)&&(nbr_of_try<MAX_CMD_SEND));
	xSemaphoreGive(semI2CResource);
	if(nbr_of_try >= MAX_CMD_SEND)
		return ERROR;
	return SUCCESS;
}

// volume: volumen que se desea setear en el dispositivo
// ctr_loudness_state: si es 0 deshabilita el control de loudness, si es 1 lo habilita.
uint8_t send_volume_esp(uint8_t volume, uint8_t ctr_loudness_state){
	uint8_t nbr_of_try = 0;
	xSemaphoreTake(semI2CResource,portMAX_DELAY);
	do{
		Buffer_tx[0] = LOUD_CONFIG_CMD;

		HAL_I2C_Master_Transmit(&hi2c1, SLAVE_ADDR, Buffer_tx , 1 ,HAL_MAX_DELAY); // Envio comando de loudness y su estado

		// envio estado habilitacion
		Buffer_tx[0] = ctr_loudness_state;
		// envio nivel de loudness en porcentaje
		Buffer_tx[1] = volume;

		HAL_I2C_Master_Transmit(&hi2c1, SLAVE_ADDR, Buffer_tx , 2 ,HAL_MAX_DELAY); // Envio comando de loudness y su estado

		vTaskDelay(300); // Cambiar por un vTaskDelay

		Buffer_tx[0] = STATE_COMAND_CMD;
		HAL_I2C_Master_Transmit(&hi2c1, SLAVE_ADDR, Buffer_tx , 1 ,HAL_MAX_DELAY); // Envio comando de verificar estado previo

		vTaskDelay(300);

		HAL_I2C_Master_Receive(&hi2c1,SLAVE_ADDR,Buffer_rx,1,HAL_MAX_DELAY);

		nbr_of_try++;
	}while((Buffer_rx[0] != COMAND_OK)&&(nbr_of_try<MAX_CMD_SEND));
	xSemaphoreGive(semI2CResource);
	if(nbr_of_try >= MAX_CMD_SEND)
		return ERROR;
	return SUCCESS;

}

uint8_t get_music_estate_esp(){
	uint8_t nbr_of_try = 0;
	uint8_t temp;
	xSemaphoreTake(semI2CResource,portMAX_DELAY);
	do{
		Buffer_tx[0] = GET_MUSIC_STATE_CMD;
		HAL_I2C_Master_Transmit(&hi2c1, SLAVE_ADDR, Buffer_tx , 1 ,HAL_MAX_DELAY); // Envio comando de guardar

		vTaskDelay(300); // Cambiar por un vTaskDelay

		HAL_I2C_Master_Receive(&hi2c1,SLAVE_ADDR,Buffer_rx,1,HAL_MAX_DELAY);

		temp = Buffer_rx[0]; // Recibo el porcentaje de la cancion que se encuentra reproducido

		Buffer_tx[0] = STATE_COMAND_CMD;

		HAL_I2C_Master_Transmit(&hi2c1, SLAVE_ADDR, Buffer_tx , 1 ,HAL_MAX_DELAY); // Envio comando de verificar estado previo

		vTaskDelay(300);

		HAL_I2C_Master_Receive(&hi2c1,SLAVE_ADDR,Buffer_rx,1,HAL_MAX_DELAY);

		nbr_of_try++;
	}while((Buffer_rx[0] != COMAND_OK)&&(nbr_of_try<MAX_CMD_SEND));
	xSemaphoreGive(semI2CResource);
	if(nbr_of_try >= MAX_CMD_SEND)
		return 255;

	//progress_music =temp; // si el comando se recibio bien lo guardo

	return temp;
}
uint8_t get_bt_estate_esp(){
	uint8_t nbr_of_try = 0;
	uint8_t temp=0;
	xSemaphoreTake(semI2CResource,portMAX_DELAY);
	do{
		Buffer_tx[0] = GET_BT_STATE_CMD;
		HAL_I2C_Master_Transmit(&hi2c1, SLAVE_ADDR, Buffer_tx , 1 ,HAL_MAX_DELAY); // Envio comando de estado BT

		vTaskDelay(300);

		HAL_I2C_Master_Receive(&hi2c1,SLAVE_ADDR,Buffer_rx,1,HAL_MAX_DELAY);

		temp = Buffer_rx[0]; // Recibo el porcentaje de la cancion que se encuentra reproducido

		Buffer_tx[0] = STATE_COMAND_CMD;

		HAL_I2C_Master_Transmit(&hi2c1, SLAVE_ADDR, Buffer_tx , 1 ,HAL_MAX_DELAY); // Envio comando de verificar estado previo

		vTaskDelay(300);

		HAL_I2C_Master_Receive(&hi2c1,SLAVE_ADDR,Buffer_rx,1,HAL_MAX_DELAY);

		nbr_of_try++;
	}while((Buffer_rx[0] != COMAND_OK)&&(nbr_of_try<MAX_CMD_SEND));
	xSemaphoreGive(semI2CResource);
	if(nbr_of_try >= MAX_CMD_SEND)
		return COMAND_FAILED;

	return temp;
}
void give_sem_save_data(){
	xSemaphoreGive(semSaveData);
}
