guidoglorioso01/Proyecto-DigitalesII-APOLO1/(commit log)

2023-12-16 Agrego codigo I2S y el control del perfil A2DP
2023-12-17 Agrego version con i2s unico de salida y ecualizando mas o menos bien
2023-12-18 Modifico codigo ESP agregando control de loudness
    [esp_bm_results.csv, partitions.csv]
2024-01-10 Commit con los archivos hasta el momento. Comienzo a trabajar sobre esto.
2024-01-14 Corregido bugs de loudness con progress bar, todo andando ok con un canal de salida
    [Control_DatosUsuario.c, Control_DatosUsuario.h, Control_ProcesamientoAudio.c, Control_ProcesamientoAudio.h, Driver_I2C.c, main.c]
2024-01-16 No esta funcionando bien, se hicieron algunos avances de Erratas que habia y se mejoro un poco la calidad de audio
    [Control_ProcesamientoAudio.h, Driver_I2S.c, Driver_I2S.h, TDII-Proyecto_Apolo-Grupo1.ioc, main.c, main.h, process.c, volume_control.c]
2024-01-16 Cambio el ESP por esclavo y ST por maestro. Se escucha un piso de ruido, no se escucha robocop. Unicamente configurado para loopback
2024-01-27 Encontre bug en los datos de entrada (0 y 1 random). Sigue habiendo ruido, unicamente loopback
    [Control_ProcesamientoAudio.h, Driver_I2S.c, TDII-Proyecto_Apolo-Grupo1.ioc, bt_app_core.c, main.c, volume_control.c, volume_control.h]
2024-02-16 Ambos filtrados funcionando. Un poco inestable, se usa el filtrado q15 fast
2024-02-17 Correccion detalles, listo para hacer rebase
2024-02-17 agrego esto que me pide
2024-02-18 Correccion de bugs y funcionalidades
    [Driver_I2S.c, process.c]
2024-02-19 Corregidos varios bugs incluido desincronizacion en desconeccion de bt. Estable
    [Control_DatosUsuario.c, Driver_I2C.c, Driver_I2C.h, Driver_I2S.c, Driver_I2S.h, main.c, process.c, process.h]
2024-02-19 Agrego codigos de ESP32 actualizados
