guidoglorioso01/Proyecto-DigitalesII-APOLO1/(notices)

Notices in the files:
TDII-Proyecto_Apolo-Grupo1/Core/Inc/main.h:
Copyright (c) 2023 STMicroelectronics.
All rights reserved.
This software is licensed under terms that can be found in the LICENSE file
